Phon1209/keeb/Schematic.png

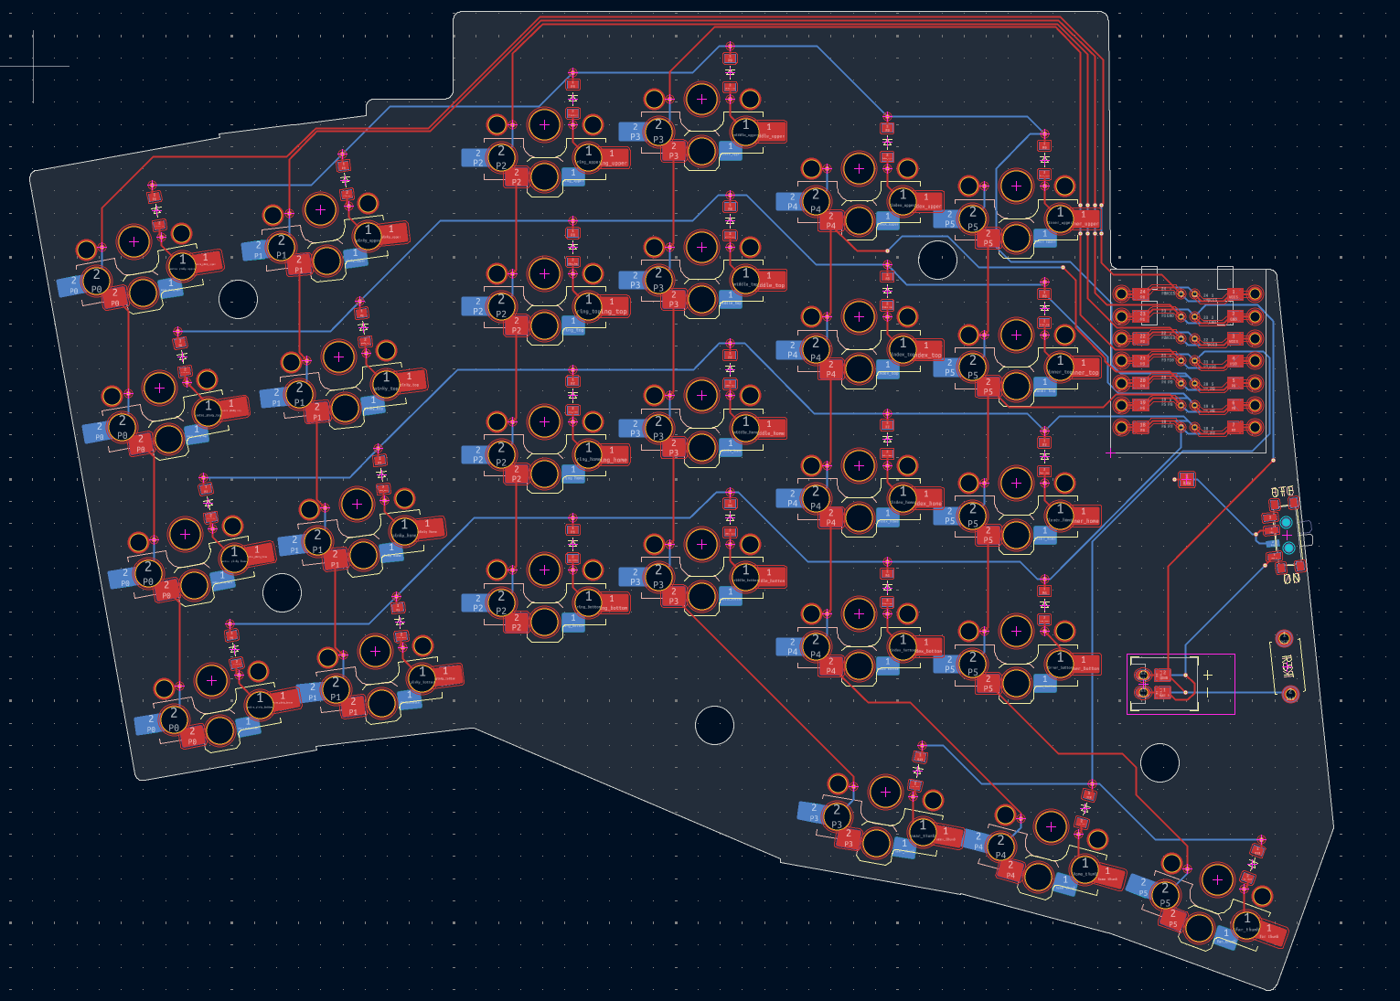
Schematic.png
