Phon1209/keeb/board_pcb_wired.kicad_pcb

## KiCad design board_pcb_wired.kicad_pcb (2026-05-05)

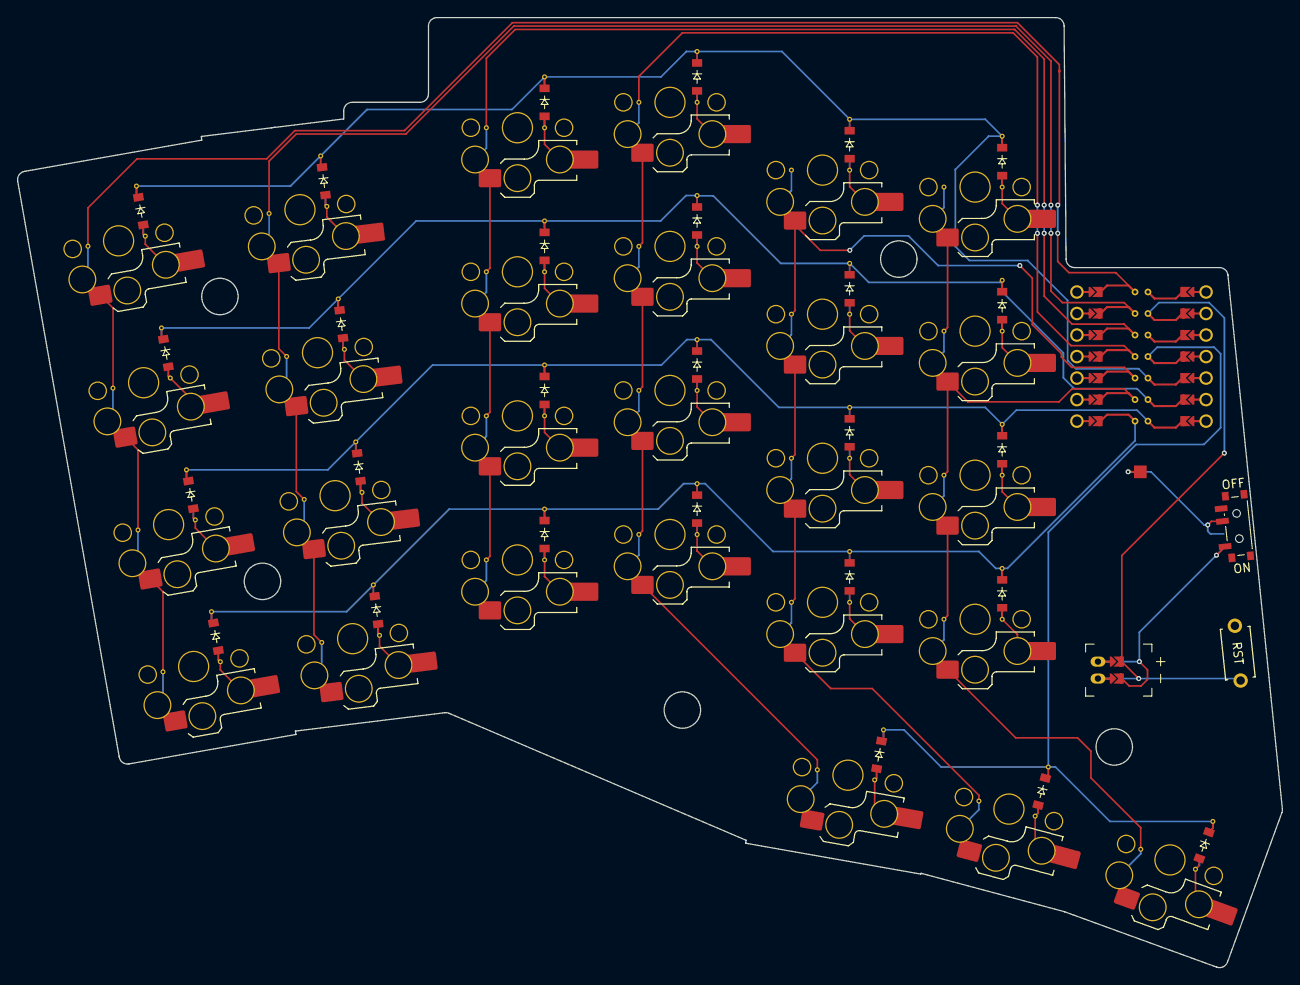
[picture p2: board board_pcb_wired.kicad_pcb from above]

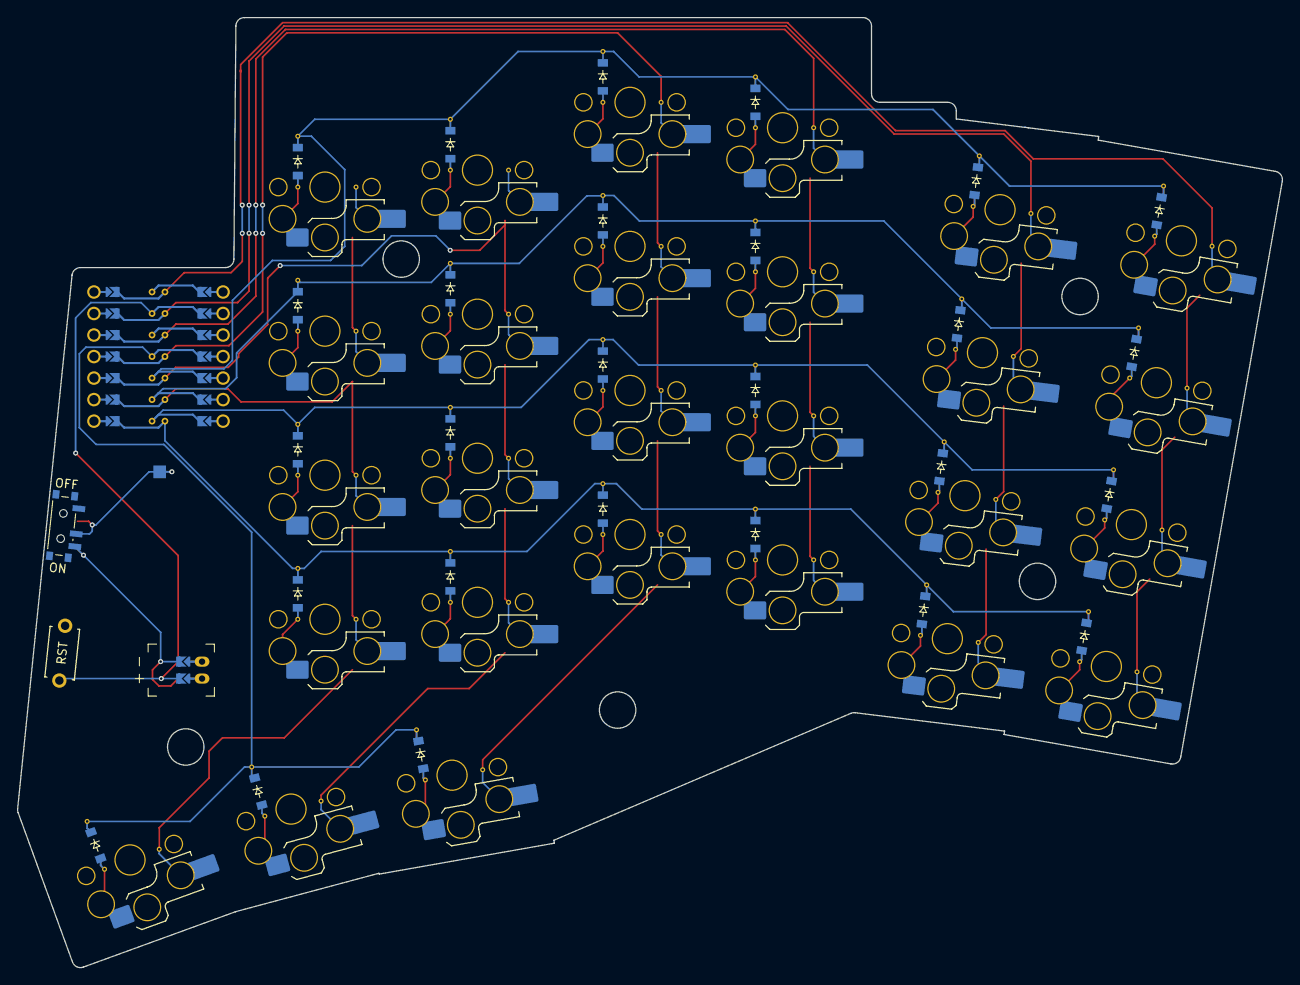
[picture p3: board board_pcb_wired.kicad_pcb from below]

Board: 2 copper layers, 149.3 x 112.1 mm, 59 parts (27 on the bottom side), 43 nets.

Parts:
D1, D2, D3, D4, D5, D6, D7, D8, D9, D10, D11, D12, D13, D14, D15, D16, D17, D18, D19, D20, D21, D22, D23, D24, D25, D26, D27: diode_tht_sod123
JST1: battery_connector_jst_ph_2
PAD1: SMDPad
PWR1: power_switch_smd_side
RST1: reset_switch_tht_top
S1, S2, S3, S4, S5, S6, S7, S8, S9, S10, S11, S12, S13, S14, S15, S16, S17, S18, S19, S20, S21, S22, S23, S24, S25, S26, S27: switch_choc_v1_v2
xiao-ble1: ProMicro; xiao-ble

Connections:
BAT_P: JST1.1, PWR1.1, PWR1.3
GND: JST1.2, RST1.2, xiao-ble1.2
JST1_1: JST1.11, JST1.21, JST1.31
JST1_2: JST1.12, JST1.22, JST1.32
P0: S1.2, S2.2, S3.2, S4.2, xiao-ble1.24
P1: S5.2, S6.2, S7.2, S8.2, xiao-ble1.23
P2: S9.2, S10.2, S11.2, S12.2, xiao-ble1.22
P3: S13.2, S14.2, S15.2, S16.2, S25.2, xiao-ble1.21
P4: S17.2, S18.2, S19.2, S20.2, S26.2, xiao-ble1.20
P5: S21.2, S22.2, S23.2, S24.2, S27.2, xiao-ble1.19
P6: D1.1, D5.1, D9.1, D13.1, D17.1, D21.1, xiao-ble1.18
P7: D2.1, D6.1, D10.1, D14.1, D18.1, D22.1, xiao-ble1.7
P8: D3.1, D7.1, D11.1, D15.1, D19.1, D23.1, xiao-ble1.6
P9: D4.1, D8.1, D12.1, D16.1, D20.1, D24.1, xiao-ble1.5
P10: D25.1, D26.1, D27.1, xiao-ble1.4
RAW: PAD1.1, PWR1.2
extra_pinky_bottom: D1.2, S1.1
extra_pinky_home: D2.2, S2.1
extra_pinky_top: D3.2, S3.1
extra_pinky_upper: D4.2, S4.1
far_thumb: D27.2, S27.1
home_thumb: D26.2, S26.1
index_bottom: D17.2, S17.1
index_home: D18.2, S18.1
index_top: D19.2, S19.1
index_upper: D20.2, S20.1
inner_bottom: D21.2, S21.1
inner_home: D22.2, S22.1
inner_top: D23.2, S23.1
inner_upper: D24.2, S24.1
middle_bottom: D13.2, S13.1
middle_home: D14.2, S14.1
middle_top: D15.2, S15.1
middle_upper: D16.2, S16.1
near_thumb: D25.2, S25.1
pinky_bottom: D5.2, S5.1
pinky_home: D6.2, S6.1
pinky_top: D7.2, S7.1
pinky_upper: D8.2, S8.1
ring_bottom: D9.2, S9.1
ring_home: D10.2, S10.1
ring_top: D11.2, S11.1
ring_upper: D12.2, S12.1
