Phon1209/keeb/(commit log)

2026-04-30 Add Kicad export from ergogen
    [board_pcb.kicad_pcb]
2026-04-30 Add Seeed Xiao footprint
2026-05-01 Make the board true flippable
    [config.yml]
2026-05-01 Use irreversible config for easier design
    [board.dxf, board_outline.dxf, board_pcb.kicad_pcb, combo.dxf, preview.dxf]
2026-05-03 Add pcb components to ergogen config
2026-05-03 Remove output directory from the repo
    [board.dxf, board_outline.dxf, board_pcb.kicad_pcb, combo.dxf, preview.dxf]
2026-05-05 Update the board kicad file
    [board_pcb.kicad_pcb, board_pcb_wired.kicad_pcb]
2026-05-16 add arduino file for testing nRF52840
2026-05-16 Add screenshot of schematic
